jmulvey123/RadioMusicSMD/RadioMusic_F rev2-1.brd

## EAGLE design RadioMusic_F rev2-1.brd (2019-11-03)

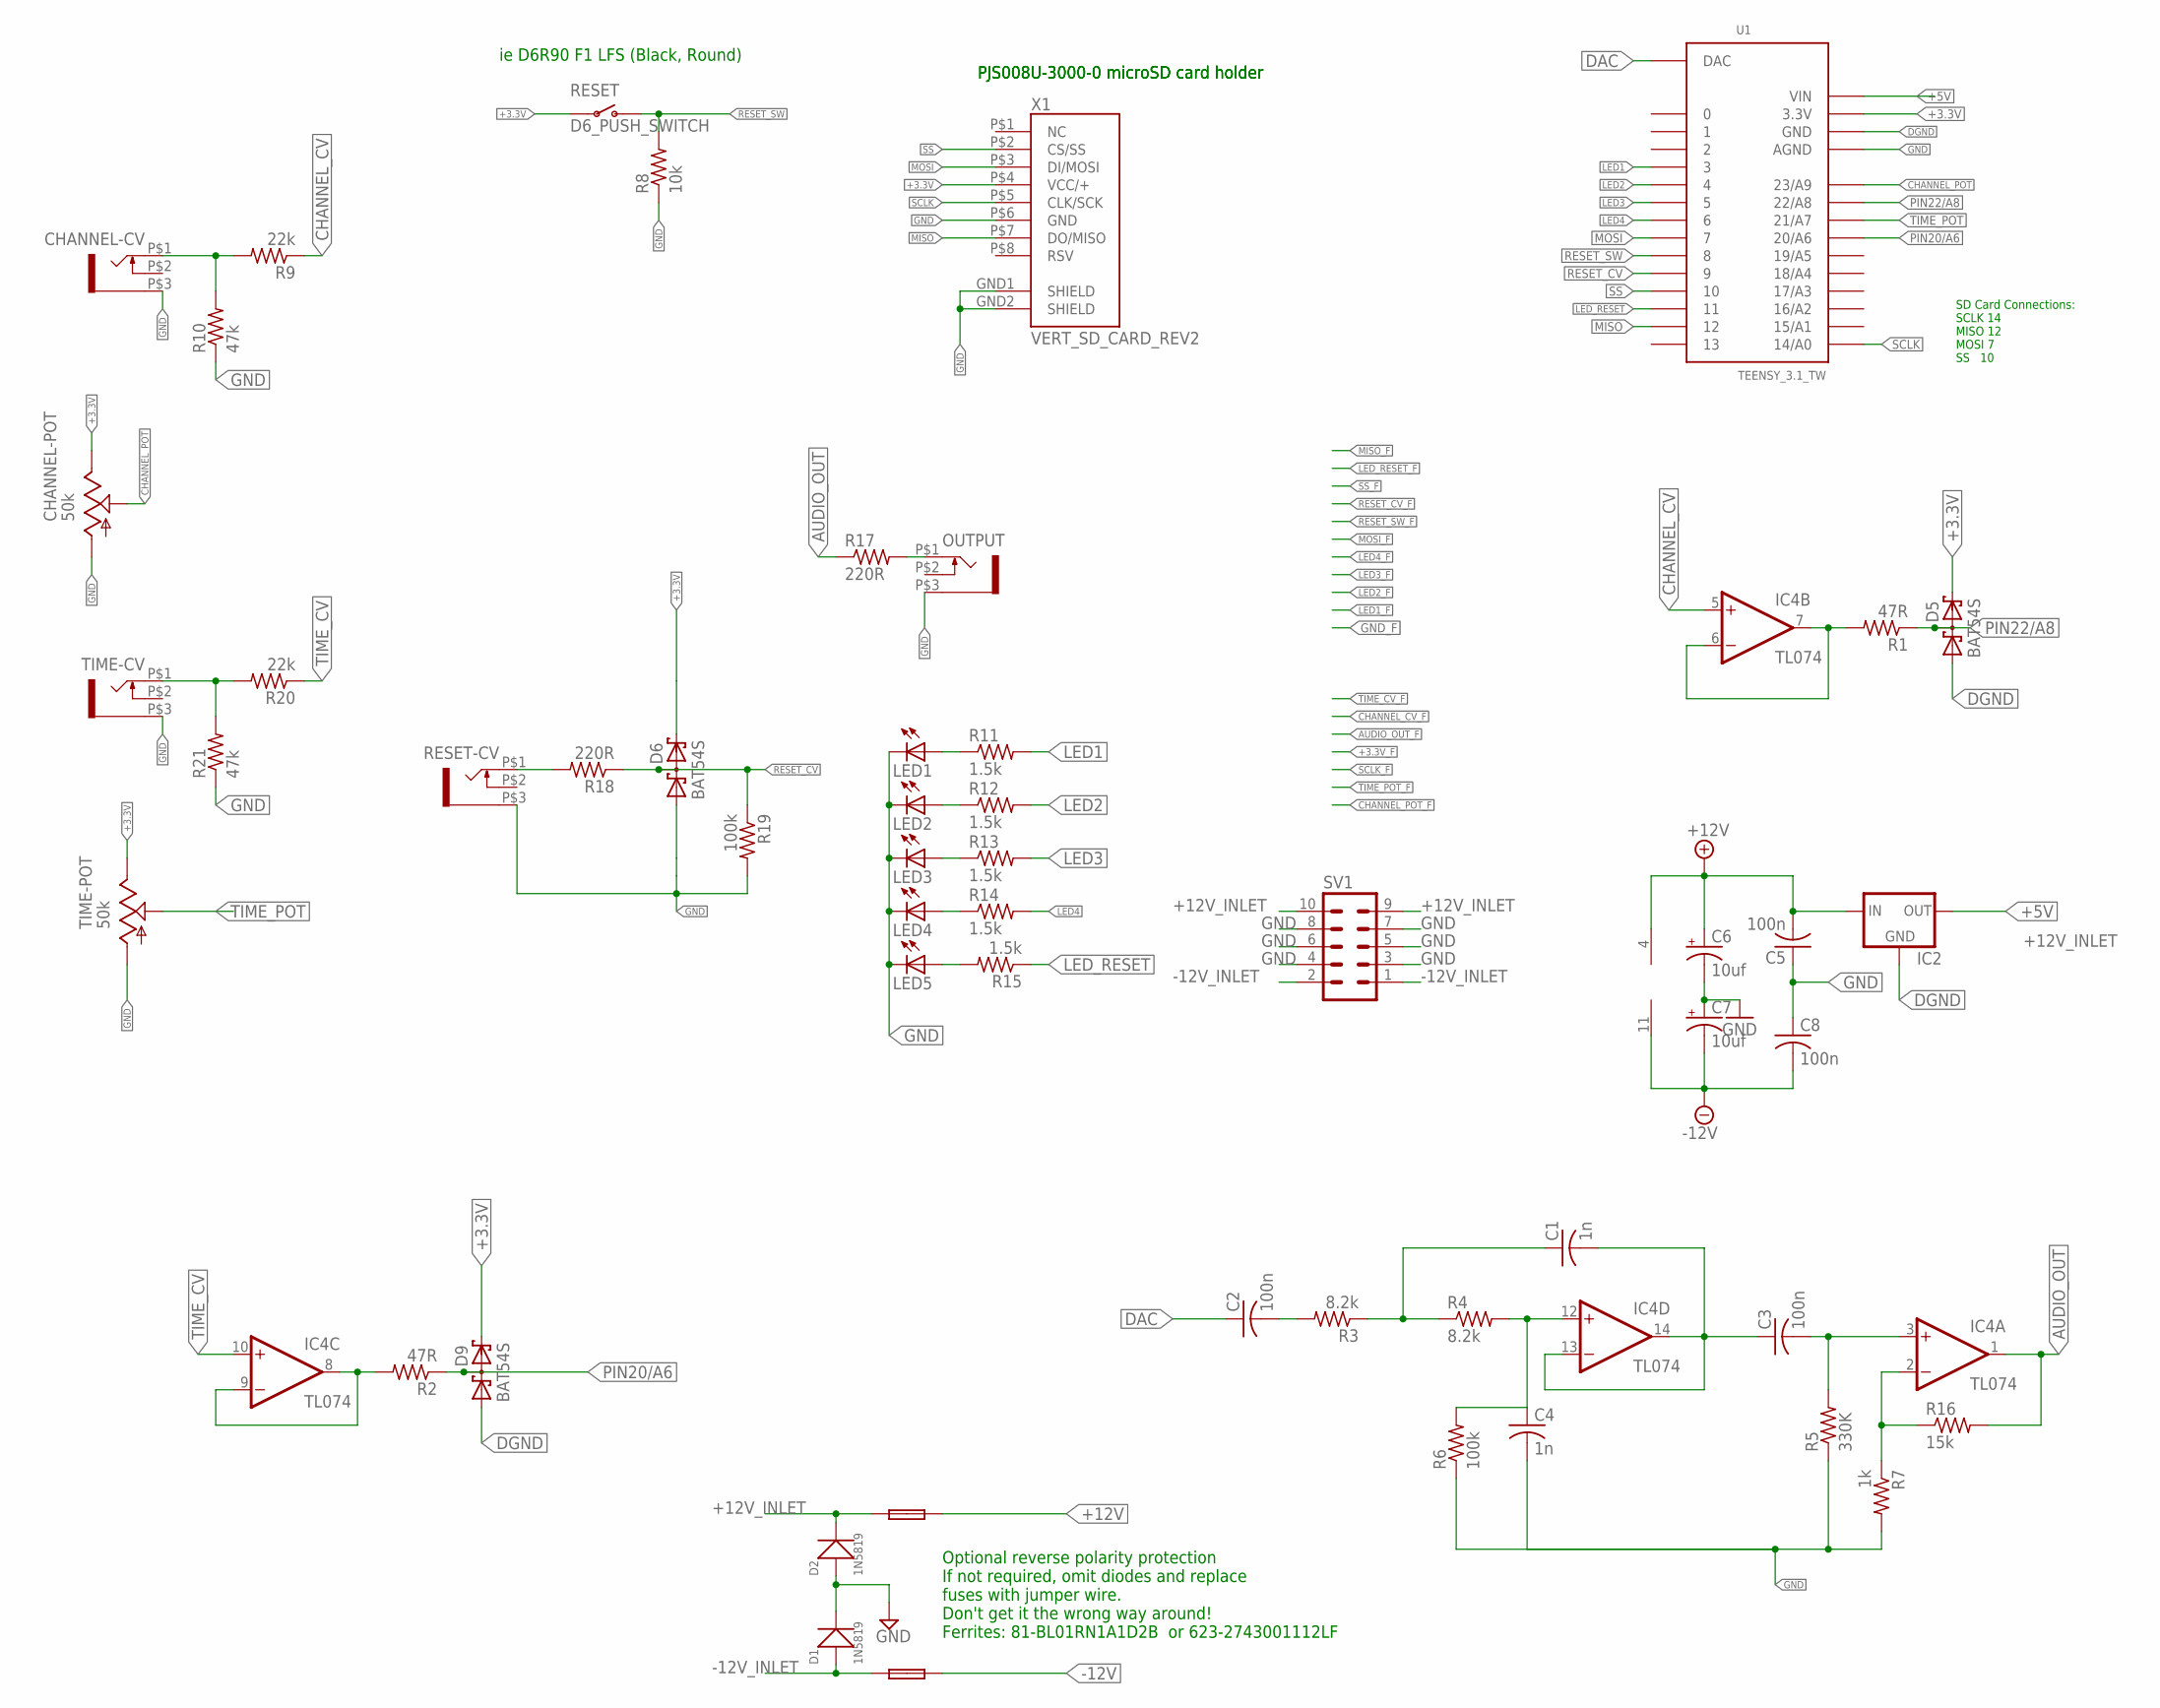
[picture p1: schematic RadioMusic_F rev2-1.sch]

Parts:
C1, C4: 1n; C0805
C2, C3, C5, C8: 100n; C0805
C6, C7: 10uf; CPOL-RADIAL-10UF-25V
CHANNEL-CV: WQP-PJ301M-12_JACK
CHANNEL-POT: 50k; EVUF
D1, D2: 1N5819; SOD-123
D5, D6, D9: BAT54S; SOT23
F1, F2: FUSE; C050H075X075
IC2: 78LXX
IC4: TL074; SO14
LED1, LED2, LED3, LED4, LED5: LED3MM
OUTPUT: WQP-PJ301M-12_JACK
R1, R2: 47R; R0805
R3, R4: 8.2k; R0805
R5: 330K; R0805
R6, R19: 100k; R0805
R7: 1k; R0805
R8: 10k; R0805
R9, R20: 22k; R0805
R10, R21: 47k; R0805
R11, R12, R13, R14, R15: 1.5k; R0805
R16: 15k; R0805
R17, R18: 220R; R0805
RESET: D6_PUSH_SWITCH; D6_BUTTON_RND
RESET-CV: WQP-PJ301M-12_JACK
SV1: 10_PIN_HEADER; MA05-2
TIME-CV: WQP-PJ301M-12_JACK
TIME-POT: 50k; EVUF
U1: TEENSY_3.1_TW
X1: VERT_SD_CARD_REV2; VERT_MICROSD_REV2

Connections:
+3.3V: CHANNEL-POT.3 (E), D5.2 (C2), D6.2 (C2), D9.2 (C2), RESET.P$3, RESET.P$4, TIME-POT.3 (E), U1.3.3V, X1.P$4 (VCC/+)
+5V: IC2.OUT, U1.VIN
+12V: C5.2, C6.1 (+), F1.2, IC2.IN, IC4.4 (V+)
+12V_INLET: D2.-, F1.1, SV1.9, SV1.10
-12V: C7.2 (-), C8.2, F2.2, IC4.11 (V-)
-12V_INLET: D1.+, F2.1, SV1.1, SV1.2
AUDIO_OUT: IC4.1 (OUT), R16.2, R17.1
CHANNEL_CV: IC4.5 (+IN), R9.1
CHANNEL_POT: CHANNEL-POT.2 (S), U1.23/A9
DAC: C2.1, U1.DAC
DGND: D5.1 (A1), D9.1 (A1), IC2.GND, U1.GND
GND: C4.2, C5.1, C6.2 (-), C7.1 (+), C8.1, CHANNEL-CV.P$3 (1), CHANNEL-POT.1 (A), D1.-, D2.+, D6.1 (A1), LED1.K (C), LED2.K (C), LED3.K (C), LED4.K (C), LED5.K (C), OUTPUT.P$3 (1), R5.1, R6.1, R7.2, R8.1, R10.1, R19.2, R21.1, RESET-CV.P$3 (1), SV1.3, SV1.4, SV1.5, SV1.6, SV1.7, SV1.8, TIME-CV.P$3 (1), TIME-POT.1 (A), U1.AGND, X1.GND1 (SHIELD), X1.GND2 (SHIELD), X1.P$6 (GND)
LED1: R11.2, U1.3
LED2: R12.2, U1.4
LED3: R13.2, U1.5
LED4: R14.2, U1.6
LED_RESET: R15.1, U1.11
MISO: U1.12, X1.P$7 (DO/MISO)
MOSI: U1.7, X1.P$3 (DI/MOSI)
unnamed: IC4.6 (-IN), IC4.7 (OUT), R1.2
unnamed: C4.1, IC4.12 (+IN), R4.2, R6.2
unnamed: OUTPUT.P$1 (2), R17.2
unnamed: C1.1, R3.1, R4.1
unnamed: C1.2, C3.1, IC4.13 (-IN), IC4.14 (OUT)
unnamed: C3.2, IC4.3 (+IN), R5.2
unnamed: IC4.2 (-IN), R7.1, R16.1
unnamed: IC4.8 (OUT), IC4.9 (-IN), R2.2
unnamed: CHANNEL-CV.P$1 (2), R9.2, R10.2
unnamed: C2.2, R3.2
unnamed: LED2.A, R12.1
unnamed: LED4.A, R14.1
unnamed: LED3.A, R13.1
unnamed: R18.2, RESET-CV.P$1 (2)
unnamed: LED1.A, R11.1
unnamed: LED5.A, R15.2
PIN20/A6: D9.3 (C1A2), R2.1, U1.20/A6
PIN22/A8: D5.3 (C1A2), R1.1, U1.22/A8
RESET_CV: D6.3 (C1A2), R18.1, R19.1, U1.9
RESET_SW: R8.2, RESET.P$1 (O), RESET.P$2 (O), U1.8
SCLK: U1.14/A0, X1.P$5 (CLK/SCK)
SS: U1.10, X1.P$2 (CS/SS)
TEMP: R20.2, R21.2, TIME-CV.P$1 (2)
TIME_CV: IC4.10 (+IN), R20.1
TIME_POT: TIME-POT.2 (S), U1.21/A7

Notes on the sheet:
ie D6R90 F1 LFS (Black, Round)
PJS008U-3000-0 microSD card holder
SD Card Connections: SCLK 14 MISO 12 MOSI 7 SS 10
Optional reverse polarity protection If not required, omit diodes and replace fuses with jumper wire. Don't get it the wrong way around! Ferrites: 81-BL01RN1A1D2B or 623-2743001112LF

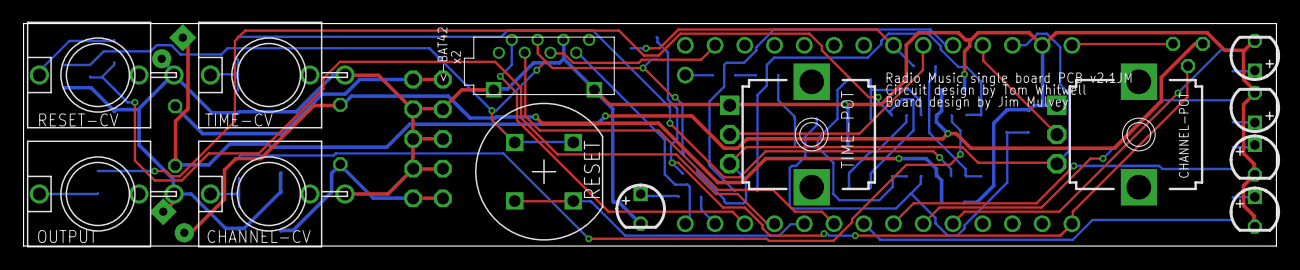
[picture p2: board RadioMusic_F rev2-1.brd from above]

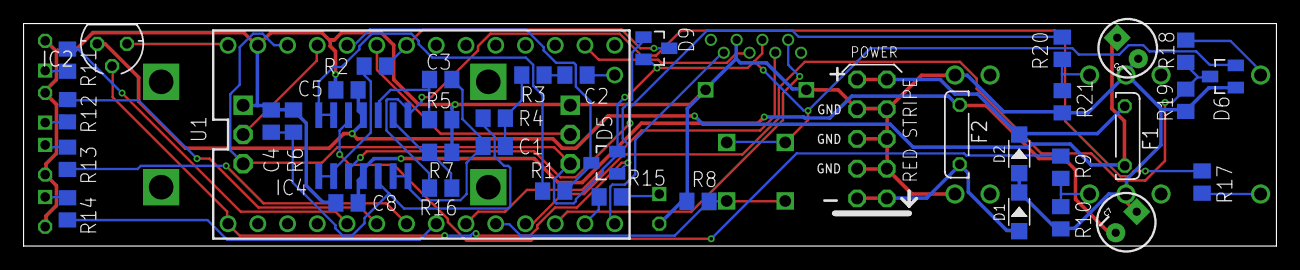
[picture p3: board RadioMusic_F rev2-1.brd from below]

Board: 4 copper layers, 107.0 x 19.0 mm, 53 parts (40 on the bottom side), 44 nets.
